AvalonROV/Electrical/Hardware/Power Board/Power-Board.pdf

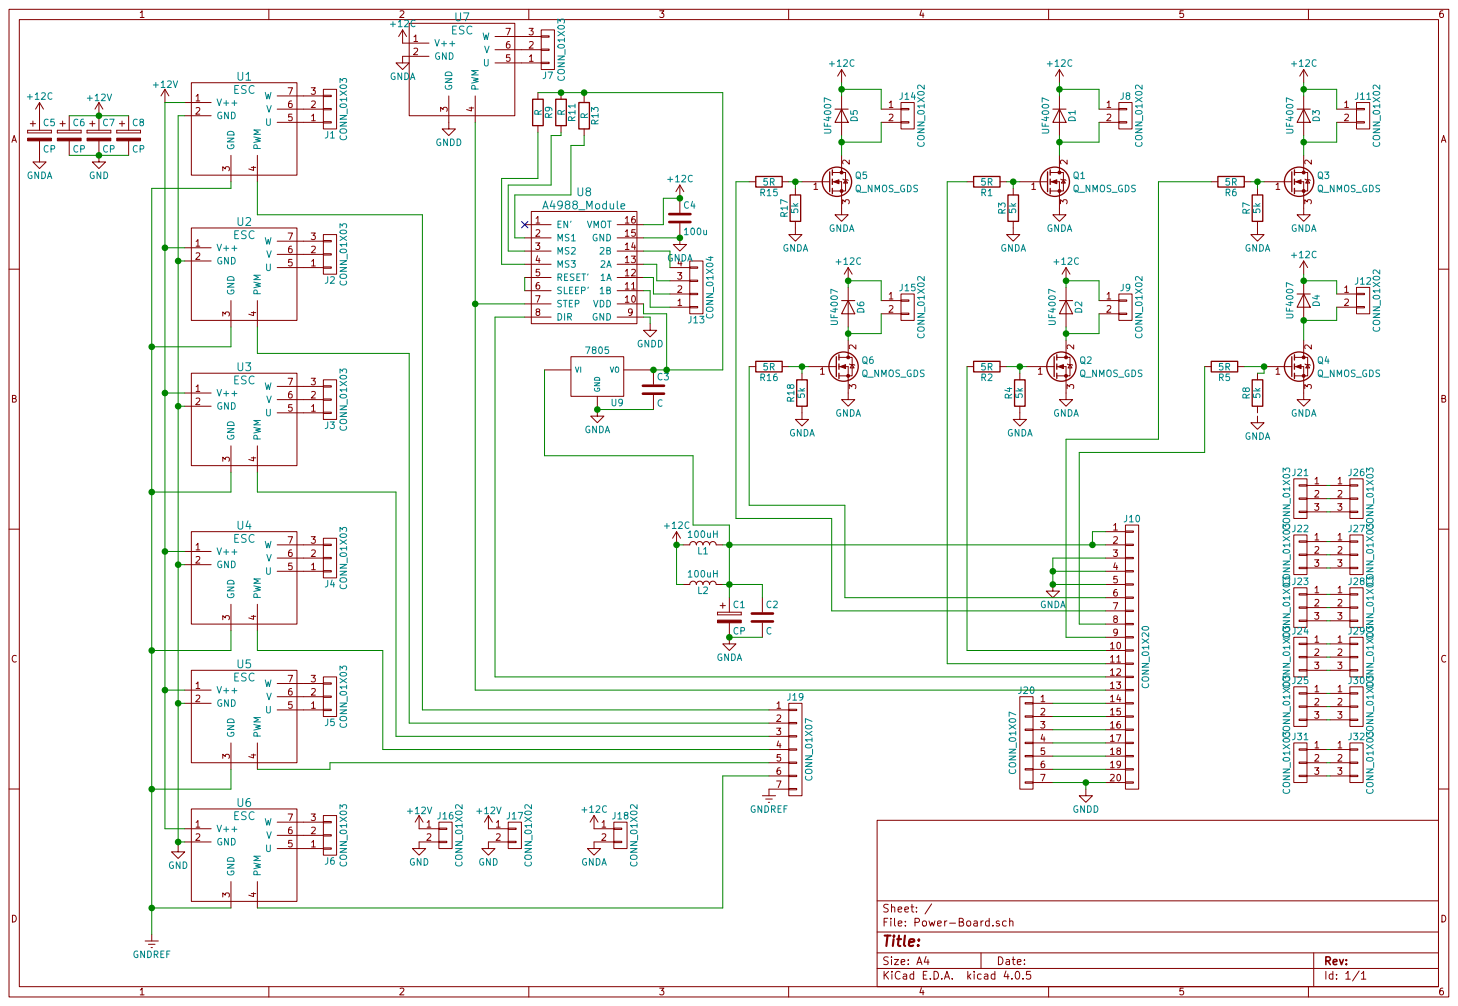
[picture p1: page 1]

15
16
17
18
19
20

J32 CONN_01X03 123

Id: 1/1 Title: File: Power-Board.sch Sheet: /
