AvalonROV/Electrical/Release Mechanism/Ultrasonic Transducer Reciever Circuit.asc

C1: cap; 10n
C2: cap; 10n
C3: cap; 10n
C4: cap; 2500p
D1: diode
R1: res; 1Meg
R2: res; 1Meg
R3: res; 1Meg
R4: res; 12k
R5: res; 1Meg
R6: res; 12k
R7: res; 10k
R9: res; 390k
R10: res; 1Meg
R12: res; 8k
R13: res; 10k
U1: UniversalOpamp2
U2: UniversalOpamp2
U3: UniversalOpamp2
V1: voltage; SINE(0 100m 40k 500u 0 0 10)
V2: voltage; 9
Named nets: 0, TP1, TP4, TP2, TP3
Ultrasonic Transducer
.tran 0 1m 0
