AvalonROV/Electrical/Release Mechanism/Ultrasonic Transducer Transmitter Circuit.asc

C1: cap; 2500p
Q1: npn; BC817-25
Q2: npn; BC817-25
Q3: pnp
Q4: pnp
Q5: npn; BC817-25
R1: res; 1K
R2: res; 1K
R3: res; 1.5K
R4: res; 1.5K
R5: res; 1.5K
R6: res; 1.5K
R7: res; 1.5K
V1: voltage; 12
V2: voltage; PULSE(0 5 0u 0.1u 0.1u 12.5u 25u)
Named nets: 0
.tran 0 10m 0
