AvalonROV/Electrical/(list of files, drawings)

Other design files:
Hardware/Communication Board/avalon_communication_board.dsn
Hardware/Release Mechanism Board/ReleaseBoard.dsn
Hardware/Topside Video Converter/Video Converter.dsn
