AvalonROV/Electrical/Hardware/Release Mechanism Board/ReleaseBoard.kicad_pcb

## KiCad design Hardware/Release Mechanism Board/ReleaseBoard.kicad_pcb (2018-03-21)

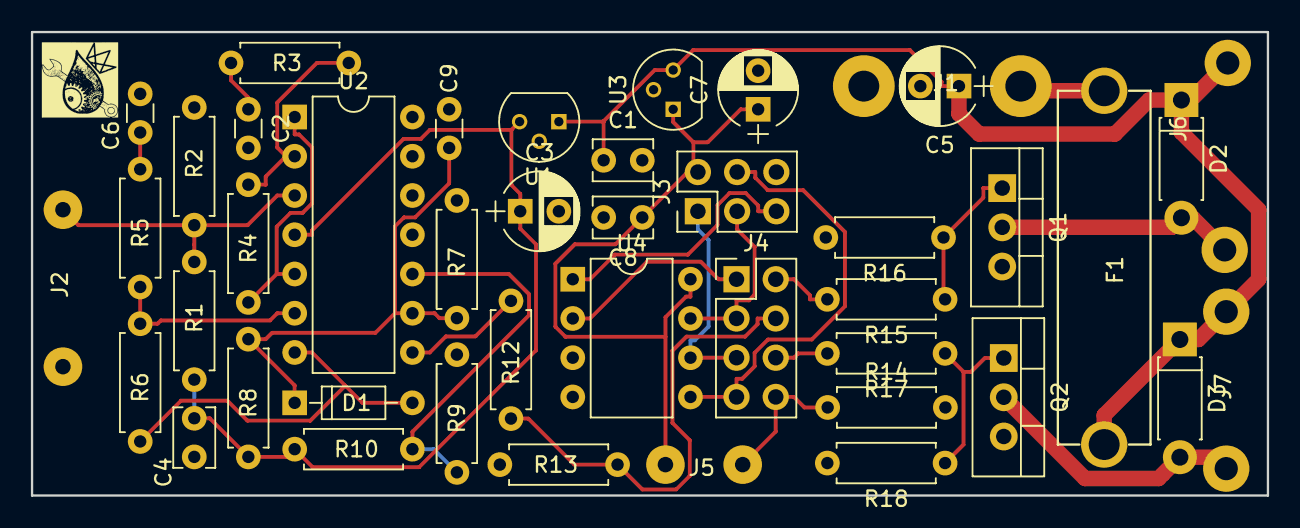
[picture p2: board ReleaseBoard.kicad_pcb from above]

Board: 2 copper layers, 80.0 x 30.0 mm, 43 parts (0 on the bottom side), 28 nets.

Parts:
C1, C4, C8: C; C_Disc_D3.8mm_W2.6mm_P2.50mm
C2, C6, C9: 10n; C_Disc_D3.0mm_W1.6mm_P2.50mm
C3, C5, C7: C; CP_Radial_D5.0mm_P2.50mm
D1: 1N4841; D_DO-35_SOD27_P7.62mm_Horizontal
D2, D3: D; D_DO-41_SOD81_P7.62mm_Horizontal
F1: Fuse; Keystone20x5FuseHolder
J1: CONN_01X02; WireConnection_2.00mmDrill
J2, J5: CONN_01X02; WireConnection_1.00mmDrill
J3: CONN_02X03; Pin_Header_Straight_2x03_Pitch2.54mm
J4: CONN_02X04; Pin_Header_Straight_2x04_Pitch2.54mm
J6, J7: CONN_01X02; WireConnection_1.50mmDrill
Q1, Q2: Q_NMOS_GDS; TO-220-3_Vertical
R1, R2, R4, R6, R9: 1M; R_Axial_DIN0207_L6.3mm_D2.5mm_P7.62mm_Horizontal
R3, R5: 12k; R_Axial_DIN0207_L6.3mm_D2.5mm_P7.62mm_Horizontal
R7, R13: 10k; R_Axial_DIN0207_L6.3mm_D2.5mm_P7.62mm_Horizontal
R8: 4.7M; R_Axial_DIN0207_L6.3mm_D2.5mm_P7.62mm_Horizontal
R10: 390k; R_Axial_DIN0207_L6.3mm_D2.5mm_P7.62mm_Horizontal
R12: 8k; R_Axial_DIN0207_L6.3mm_D2.5mm_P7.62mm_Horizontal
R14, R15, R16, R17, R18: R; R_Axial_DIN0207_L6.3mm_D2.5mm_P7.62mm_Horizontal
U1: LM7809CT; TO-92_Molded_Narrow
U2: LM324; DIP-14_W7.62mm
U3: LM78L05ACZ; TO-92_Molded_Narrow
U4: ATTINY85-20PU; DIP-8_W7.62mm

Connections:
+5V: C7.1, C8.1, J3.2, J5.1, U3.1, U4.8
+12V: C1.1, C5.1, D2.1, D3.1, F1.1, J6.1, J7.1, U1.1, U3.3
GND: C1.2, C2.2, C3.2, C4.2, C5.2, C6.2, C7.2, C8.2, C9.2, J1.2, J2.2, J3.6, Q1.3, Q2.3, R2.2, R7.1, R9.2, R13.2, R14.2, R16.2, R18.2, U1.2, U2.11, U3.2, U4.4
unnamed: C2.1, R3.2
unnamed: C3.1, C4.1, R1.1, R8.1, R10.1, U1.3, U2.4
unnamed: C6.1, R5.2
unnamed: C9.1, D1.1, R7.2, R8.2, U2.9
unnamed: D1.2, R6.1, U2.7
unnamed: D2.2, J6.2, Q1.2
unnamed: D3.2, J7.2, Q2.2
unnamed: F1.2, J1.1
unnamed: J2.1, R1.2, R2.1, U2.3
unnamed: J3.1, J4.5, U4.6
unnamed: J3.3, J4.3, U4.7
unnamed: J3.4, J4.7, U4.5
unnamed: J3.5, U4.1
unnamed: J4.1, U4.2
unnamed: J4.2, R15.2
unnamed: J4.4, R12.2, R13.1
unnamed: J4.6, R17.2
unnamed: J4.8, J5.2, R14.1
unnamed: Q1.1, R15.1, R16.1
unnamed: Q2.1, R17.1, R18.1
unnamed: R3.1, R4.2, U2.2
unnamed: R4.1, U2.1, U2.5
unnamed: R5.1, R6.2, U2.6
unnamed: R9.1, R10.2, U2.10
unnamed: R12.1, U2.8
