AvalonROV/Electrical/Hardware/Topside Video Converter/Video Converter.kicad_pcb

## KiCad design Hardware/Topside Video Converter/Video Converter.kicad_pcb (2018-03-21)

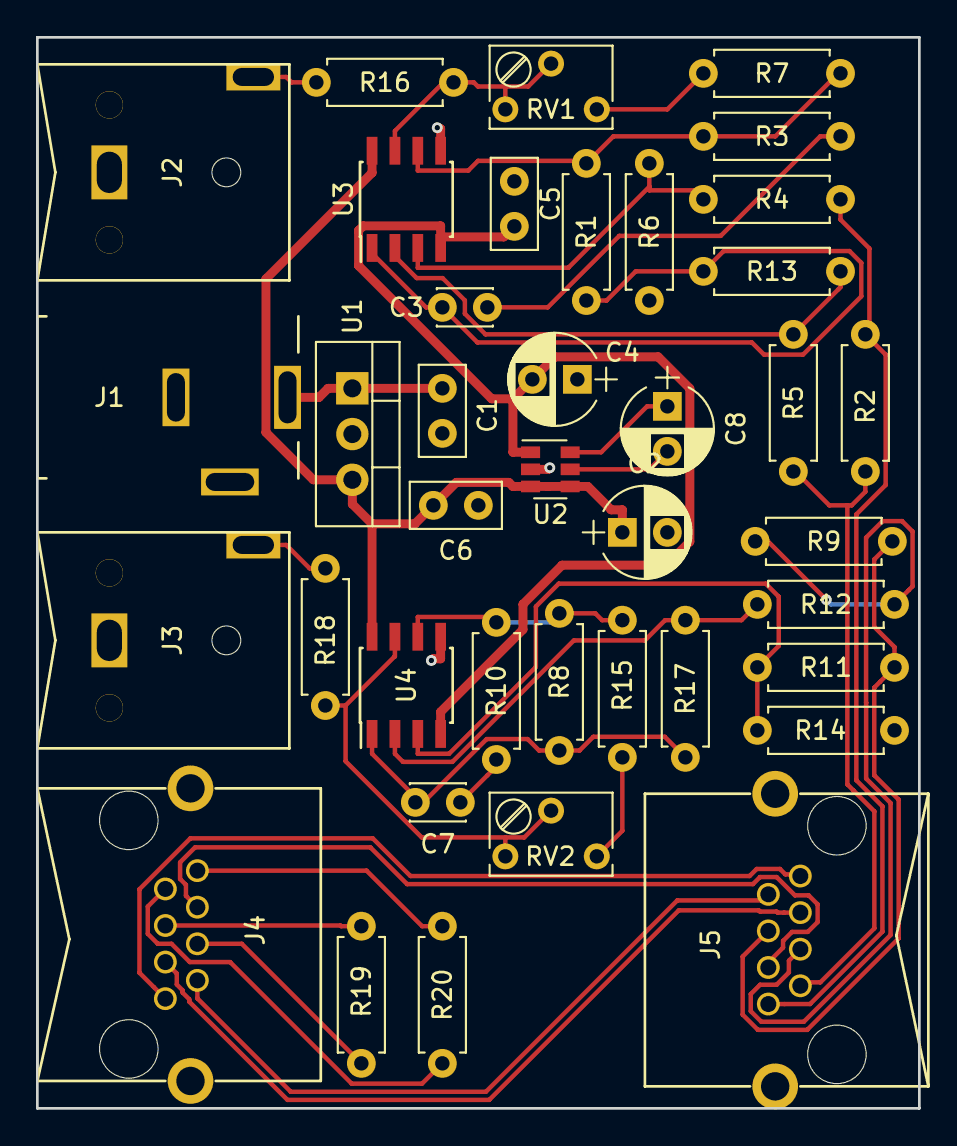
[picture p3: board Video Converter.kicad_pcb from above]

Board: 2 copper layers, 49.0 x 59.5 mm, 39 parts (0 on the bottom side), 34 nets.

Parts:
C1, C5, C6: C; C_Disc_D5.0mm_W2.5mm_P2.50mm
C2: C; CP_Radial_D5.0mm_P2.50mm
C3, C7: 68p; C_Disc_D3.0mm_W2.0mm_P2.50mm
C4: 10u; CP_Radial_D5.0mm_P2.50mm
C8: 1u; CP_Radial_D5.0mm_P2.50mm
J1: CONN_01X02; RS_5.5mmSocket
J2, J3: CONN_01X02; RCA_Jack_4890.2250
J4, J5: RJ45; TE_RJ45
R1, R4, R5, R8, R11, R12, R13, R14, R17: 3k; R_Axial_DIN0207_L6.3mm_D2.5mm_P7.62mm_Horizontal
R2, R9: 86R6; R_Axial_DIN0207_L6.3mm_D2.5mm_P7.62mm_Horizontal
R3, R10: 3k9; R_Axial_DIN0207_L6.3mm_D2.5mm_P7.62mm_Horizontal
R6, R19, R20: R; R_Axial_DIN0207_L6.3mm_D2.5mm_P7.62mm_Horizontal
R7, R15: 1k5; R_Axial_DIN0207_L6.3mm_D2.5mm_P7.62mm_Horizontal
R16, R18: 75R; R_Axial_DIN0207_L6.3mm_D2.5mm_P7.62mm_Horizontal
RV1, RV2: 1k; Potentiometer_Trimmer_Bourns_3266W
U1: LM7805; TO-220-3_Vertical
U2: LM2776; SOT-23-6
U3, U4: OPA2340; SOIC-8_3.9x4.9mm_Pitch1.27mm

Connections:
+5V: C2.1, C6.1, U1.3, U2.3, U2.4, U3.8, U4.8
GND: C1.2, C2.2, C4.1, C5.1, C6.2, J1.1, J2.2, J3.2, J4.9, J5.9, R6.2, R14.2, U1.2, U2.2, U3.5, U4.5
unnamed: C1.1, J1.2, U1.1
unnamed: C3.1, R3.2
unnamed: C3.2, R1.2, R13.1, U3.1
unnamed: C4.2, C5.2, U2.1, U3.4, U4.4
unnamed: C7.1, R10.2
unnamed: C7.2, R8.2, R17.1, U4.1
unnamed: C8.1, U2.6
unnamed: C8.2, U2.5
unnamed: J2.1, R16.1
unnamed: J3.1, R18.1
unnamed: J4.1, J5.1
unnamed: J4.2, J5.2
unnamed: J4.3, J5.3
unnamed: J4.4, R19.1
unnamed: J4.5, R19.2
unnamed: J4.6, J5.6
unnamed: J4.7, R20.1
unnamed: J4.8, R20.2
unnamed: J5.4, R9.1, R11.2
unnamed: J5.5, R9.2, R12.2
unnamed: J5.7, R2.2, R5.2
unnamed: J5.8, R2.1, R4.2
unnamed: R1.1, R3.1, R7.2, U3.6
unnamed: R4.1, R6.1, U3.3
unnamed: R7.1, RV1.3
unnamed: R8.1, R10.1, R15.2, U4.6
unnamed: R11.1, R14.1, U4.3
unnamed: R12.1, R17.2, U4.2
unnamed: R5.1, R13.2, U3.2
unnamed: R15.1, RV2.3
unnamed: R16.2, RV1.1, RV1.2, U3.7
unnamed: R18.2, RV2.1, RV2.2, U4.7
