AvalonROV/Electrical/Hardware/Communication Board/avalon_communication_board.kicad_pcb

## KiCad design Hardware/Communication Board/avalon_communication_board.kicad_pcb (2018-03-19)

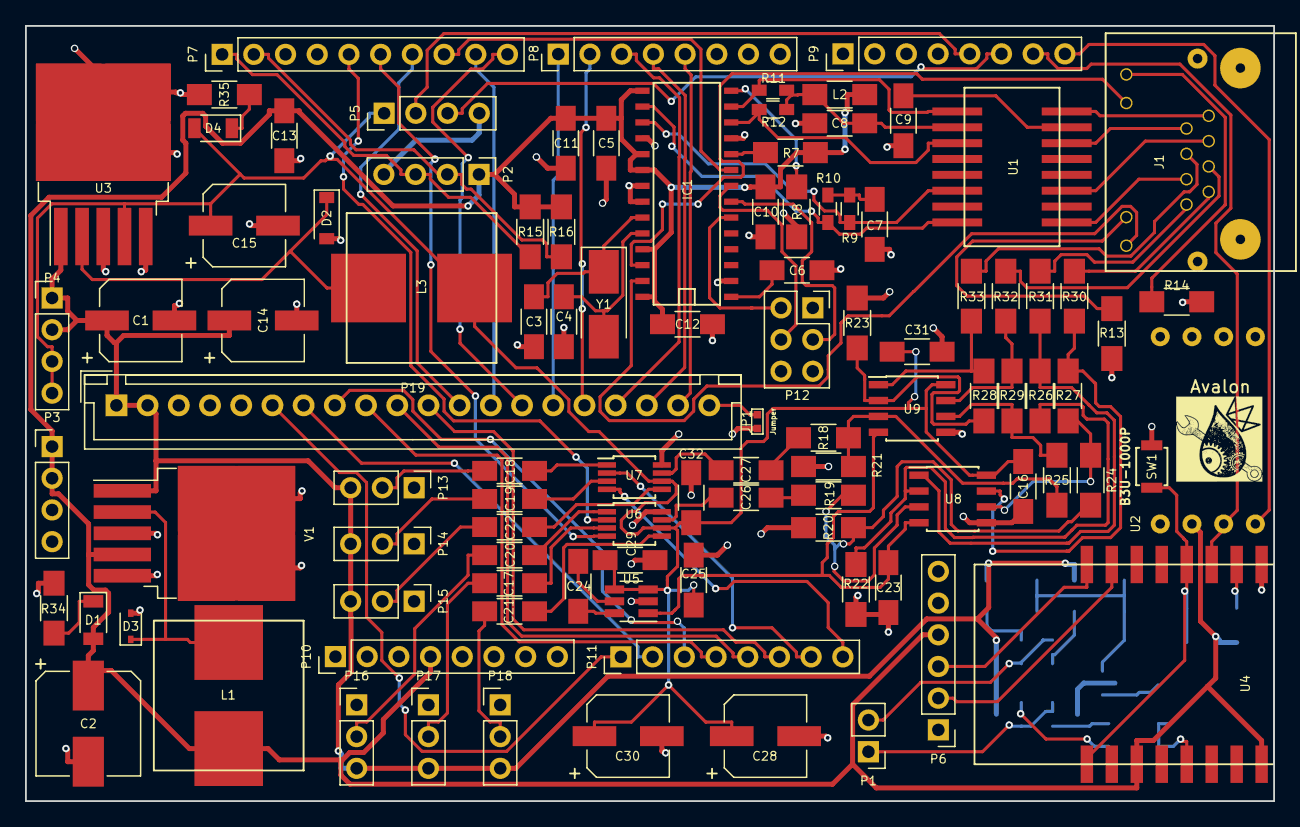
[picture p4: board avalon_communication_board.kicad_pcb from above]

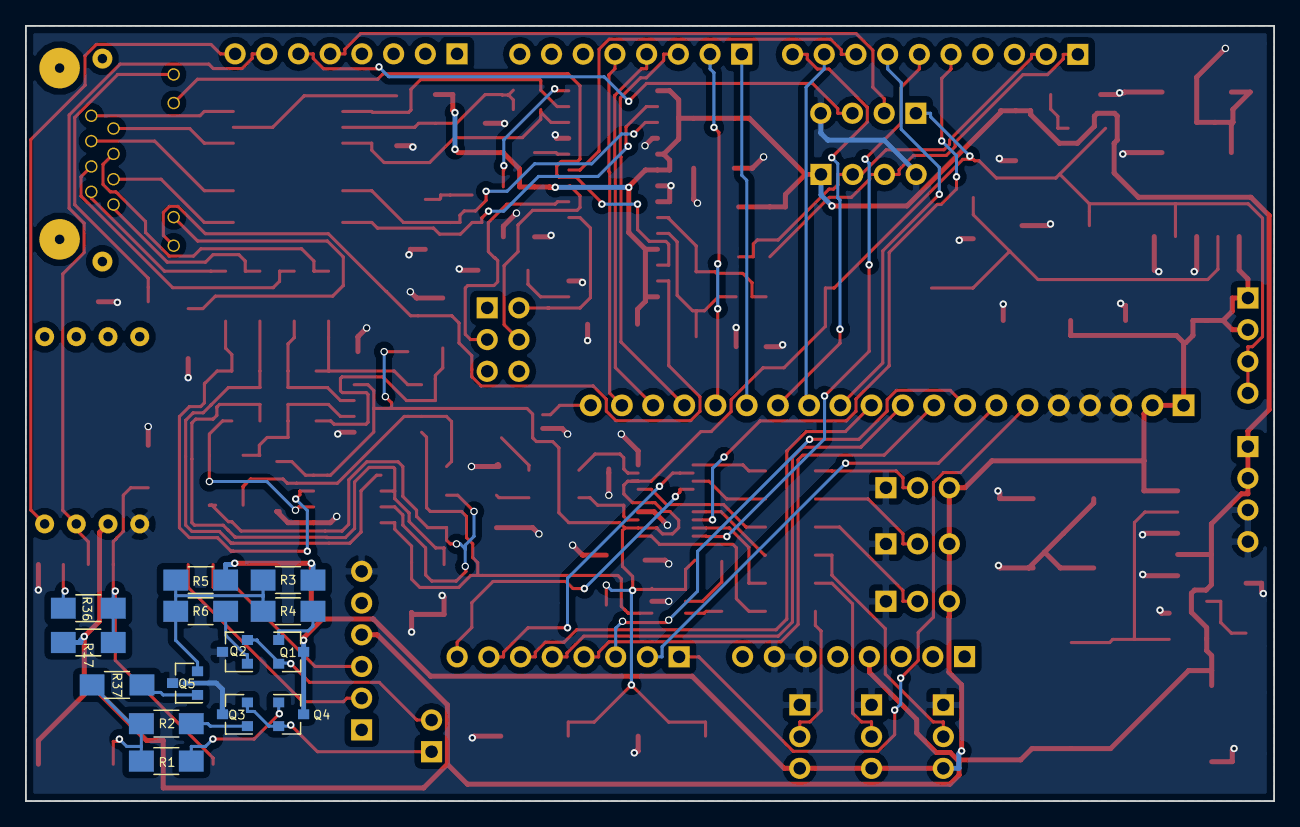
[picture p5: board avalon_communication_board.kicad_pcb from below]

Board: 2 copper layers, 100.0 x 62.1 mm, 115 parts (14 on the bottom side), 103 nets.

Parts:
C1, C14: 100uF; CP_Elec_6.3x7.7
C2: 1000uF; CP_Elec_8x10
C3, C4: 18pF; C_1206_HandSoldering
C5, C10, C11, C12, C17, C18, C19, C20, C21, C22, C25, C29, C31, C32: 0.1uF; C_1206_HandSoldering
C6: 10uF; C_1206_HandSoldering
C7, C8: 10nF; C_1206_HandSoldering
C9: 1nF; C_1206_HandSoldering
C13: 100nF; C_1206_HandSoldering
C15: 330uF; CP_Elec_6.3x7.7
C16, C23: 2.2uF; C_1206_HandSoldering
C24: 1uF; C_1206_HandSoldering
C26, C27: 470uF; C_1206_HandSoldering
C28, C30: 47uF; CP_Elec_6.3x7.7
D1: BAT60BE; D_SOD-323
D2: 1N5819; D_SOD-123
D3, D4: LED; D_1206
IC1: ENC28J60-I/SO; SOIC-28
J1: RJ45_LEDS; RJHSE-5381
JP1: Jumper; 0402
L1: 100uH; MSS1278T-334KLD
L2: Ferrite_Bead; R_1206_HandSoldering
L3: 330uH; MSS1278T-334KLD
P1: MC34629; Socket_Strip_Straight_1x02_Pitch2.54mm
P2, P3, P4, P5: MC34633; Socket_Strip_Straight_1x04_Pitch2.54mm
P6: 6 Pin SIL; Socket_Strip_Straight_1x06_Pitch2.54mm
P7: 10 Pin SIL; Socket_Strip_Straight_1x10_Pitch2.54mm
P8, P9, P10, P11: 8 Pin SIL; Socket_Strip_Straight_1x08_Pitch2.54mm
P12: 2x3 Pin SIL; Socket_Strip_Straight_2x03_Pitch2.54mm
P13, P14, P15, P16, P17, P18: MC34631; Socket_Strip_Straight_1x03_Pitch2.54mm
P19: Power Board Connector; JST_XH_B20B-XH-A_20x2.50mm_Straight
Q1, Q4: FMMT597; SOT-23
Q2, Q3, Q5: BC817; SOT-23
R1, R2, R4, R5, R24, R25, R37: 1.5K; R_1206_HandSoldering
R3, R6: 1K; R_1206_HandSoldering
R7, R17, R36: 100K; R_1206_HandSoldering
R8: 2K; R_1206_HandSoldering
R9, R10, R11, R12: 50R; R_0603_HandSoldering
R13, R14, R34: 100R; R_1206_HandSoldering
R15, R16: 10K; R_1206_HandSoldering
R18, R19, R20, R21: 75R; R_1206_HandSoldering
R22, R23, R26, R27, R28, R29: 3K; R_1206_HandSoldering
R30, R31, R32, R33: 43R; R_1206_HandSoldering
R35: 220R; R_1206_HandSoldering
SW1: B3U-1000P
U1: B78476A8247A003
U2: MPU9250
U3: LM2575S; TO-263-5_TabPin3
U4: ESP-12S; ESP12
U5: LM2776; SOT-23-6_Handsoldering
U6, U7: BH76330FVM; MSOP-8_3x3mm_Pitch0.65mm
U8, U9: LMH6643; SOIC-8_3.9x4.9mm_Pitch1.27mm
V1: LM2576; TO-263-5_TabPin3
Y1: ABM3-25MHz; Crystal_SMD_5032-2pin_5.0x3.2mm_HandSoldering

Connections:
+3V3: C2.1, C5.1, C10.1, C11.1, C12.1, C13.1, D3.2, IC1.15, IC1.19, IC1.20, IC1.25, IC1.28, L1.2, L2.1, P2.1, P3.1, P3.2, P6.4, P10.4, R7.1, R15.1, R16.1, R17.1, U2.3, U4.3, U4.8, V1.4
+5V: C15.1, C16.1, C25.1, C28.1, C29.1, C30.1, C31.1, C32.1, D4.2, L3.1, P4.3, P4.4, P5.1, U3.4, U5.3, U5.4, U6.6, U7.6, U8.8, U9.8
+12V: C1.1, C14.1, P4.1, P4.2, P13.3, P14.3, P15.3, P16.3, P17.3, P18.3, P19.1, P19.2, Q1.3, Q4.3, R3.1, R6.1, U3.1, V1.1
-5V: C23.1, U5.1, U8.4, U9.4
BLUE_RX: P5.2, P9.5
BLUE_TX: P5.3, P9.6
CAM1A: J1.8, R31.1
CAM1B: J1.7, R30.1
CAM2A: J1.4, R33.1
CAM2B: J1.5, R32.1
ESP_SCL: P9.8, U2.1
ESP_SDA: P9.7, U2.2, U4.11
Ether_CS': IC1.9, P7.8
Ether_SCK: IC1.8, P12.4
Ether_SI: IC1.7, P12.3
Ether_SO: IC1.6, P12.2
GND: C1.2, C2.2, C3.2, C4.2, C5.2, C6.2, C7.2, C8.2, C9.2, C10.2, C11.2, C12.2, C13.2, C14.2, C15.2, C16.2, C23.2, C25.2, C28.2, C29.2, C30.2, C31.2, C32.2, D1.2, D2.2, IC1.2, IC1.11, IC1.18, IC1.21, IC1.22, JP1.2, P2.4, P3.3, P3.4, P5.4, P6.6, P10.6, P10.7, P13.1, P14.1, P15.1, P16.1, P17.1, P18.1, P19.3, P19.4, P19.5, Q2.3, Q3.3, Q5.3, R8.2, R13.2, R14.1, R20.2, R21.2, R22.2, R23.2, R34.2, R35.2, SW1.1, U2.4, U3.3, U3.5, U4.9, U5.2, U6.8, U7.8, U8.5, U9.5, V1.3, V1.5
GPIO_11: P7.7, P19.12
GPIO_12: P7.6, U6.4
GPIO_13: P7.5, U6.2
GPIO_54: P11.1, P19.6
GPIO_55: P11.2, P19.7
GPIO_56: P11.3, P19.8
GPIO_57: P11.4, P19.9
GPIO_58: P11.5, P19.10
GPIO_59: P11.6, P19.11
GPIO_60: P11.7, U7.2
GPIO_61: P11.8, U7.4
LEDA: IC1.27, J1.12
LEDB: IC1.26, J1.10
unnamed: C3.1, IC1.23, Y1.1
unnamed: C4.1, IC1.24, Y1.2
unnamed: C6.1, IC1.1
unnamed: C7.1, R9.2, R10.1
unnamed: C8.1, L2.2, R11.2, R12.1, U1.2
unnamed: C9.1, U1.15
unnamed: C17.1, U6.3
unnamed: C17.2, P17.2
unnamed: C18.1, U7.1
unnamed: C18.2, P13.2
unnamed: C19.1, P15.2
unnamed: C19.2, U7.5
unnamed: C20.1, P16.2
unnamed: C20.2, U6.1
unnamed: C21.1, U6.5
unnamed: C21.2, P18.2
unnamed: C22.1, U7.3
unnamed: C22.2, P14.2
unnamed: C24.1, U5.6
unnamed: C24.2, U5.5
unnamed: C26.1, U6.7
unnamed: C26.2, R19.1
unnamed: C27.1, U7.7
unnamed: C27.2, R18.1
unnamed: D1.1, L1.1, V1.2
unnamed: D2.1, L3.2, U3.2
unnamed: D3.1, R34.1
unnamed: D4.1, R35.1
unnamed: IC1.10, R7.2
unnamed: IC1.12, R12.2, U1.3
unnamed: IC1.13, R11.1, U1.1
unnamed: IC1.14, R8.1
unnamed: IC1.16, R10.2, U1.8
unnamed: IC1.17, R9.1, U1.6
unnamed: J1.1, U1.16
unnamed: J1.2, U1.14
unnamed: J1.3, U1.11
unnamed: J1.6, U1.9
unnamed: J1.9, R14.2
unnamed: J1.11, R13.1
unnamed: JP1.1, P19.20
unnamed: P1.1, Q3.2, Q4.2
unnamed: P1.2, Q1.2, Q2.2
unnamed: P6.2, U4.15
unnamed: P6.3, U4.16
unnamed: Q1.1, R4.1
unnamed: Q2.1, R5.2
unnamed: Q3.1, R2.2
unnamed: Q4.1, R1.1
unnamed: Q5.1, R37.2
unnamed: Q5.2, R3.2, R4.2, R5.1, R6.2
unnamed: R17.2, R36.2, SW1.2, U4.1, U4.12
unnamed: R18.2, R21.1, R25.2, U9.3
unnamed: R19.2, R20.1, R24.2, U8.3
unnamed: R22.1, R26.2, U8.2
unnamed: R23.1, R28.2, U9.2
unnamed: R24.1, R27.2, U8.6
unnamed: R25.1, R29.2, U9.6
unnamed: R26.1, R31.2, U8.1
unnamed: R27.1, R30.2, U8.7
unnamed: R28.1, R33.2, U9.1
unnamed: R29.1, R32.2, U9.7
unnamed: R36.1, U4.10
POW_PWM_0: P7.9, P19.13
POW_PWM_1: P7.10, P19.14
POW_PWM_2: P8.1, P19.15
POW_PWM_3: P8.2, P19.16
POW_PWM_4: P8.3, P19.17
POW_PWM_5: P8.4, P19.18
POW_PWM_6: P8.5, P19.19
P_SCL: P2.3, P7.1, R15.2
P_SDA: P2.2, P7.2, R16.2
ULTRA_CTRL: R1.2, R2.1, R37.1, U4.5
