AvalonROV/Electrical/Hardware/Topside Video Converter/Fathom-S.brd

## EAGLE design Hardware/Topside Video Converter/Fathom-S.brd (2018-03-21)

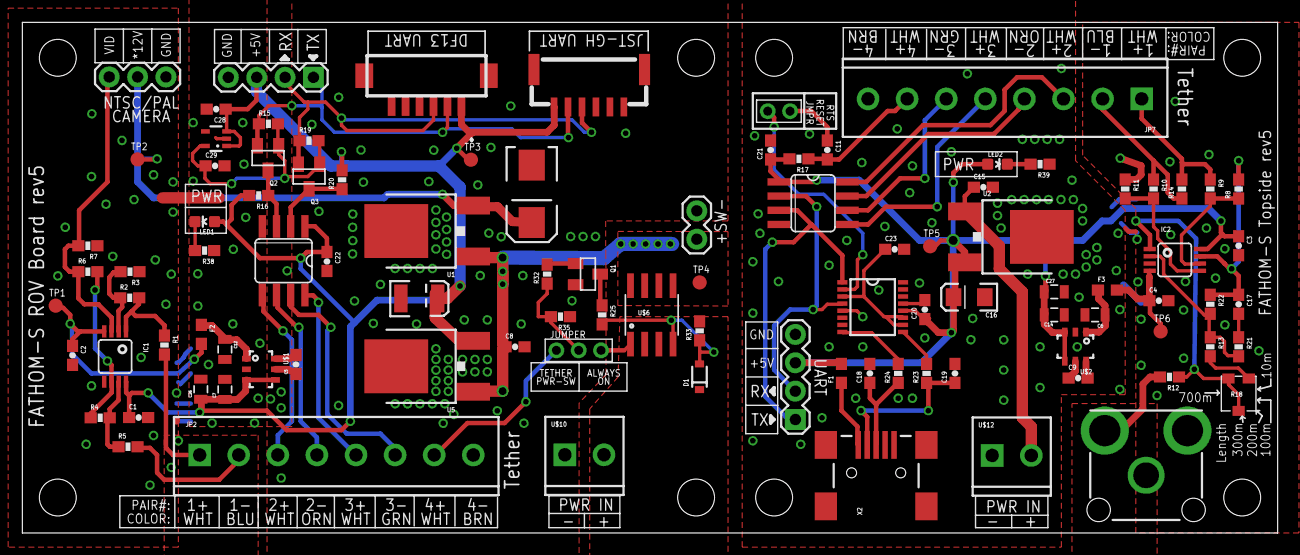
[picture p6: board Fathom-S.brd from above]

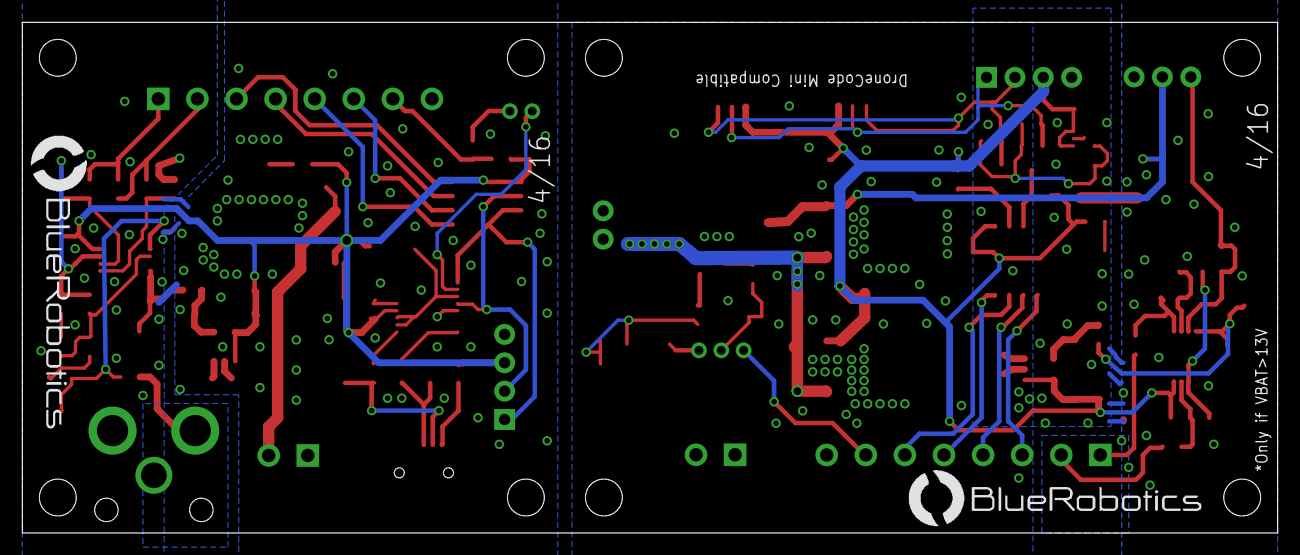
[picture p7: board Fathom-S.brd from below]

Board: 2 copper layers, 112.4 x 45.7 mm, 110 parts (2 on the bottom side), 64 nets.

Parts:
C1, C2, C3, C4, C8, C15, C20, C21, C22, C23: 0.1uF; 0603-CAP
C5, C9: 1uF X5R 35V; 0603-CAP
C6, C7, C12, C14, C26, C27: 10uF X5R 10V; 0805
C10: 47uF 10V; EIA3528
C11, C28, C29: 1uF; 0603-CAP
C13: 33uF 20V; C2413
C16: 10uF 16V; EIA3216
C17: 68pF; 0603-CAP
C18, C19: 47pF; 0603-CAP
D1: 16V; SOD-323
F1, F2, F3: 500mA; 0603
IC1, IC2: LMH6643; MSOP8
IC3, IC4: ST490AB; SO08
IC5: FT230XS; SSOP16
JP1: 1X04
JP2, JP7: 3.5MM SCREW; SCREWTERMINAL-3.5MM-8
JP3: 0.1" HEADER; 1X03
JP5: M02PTH; 1X02
JP6: PJRAN1X1U04X; RCA
JP15: 0.1" HEADER; 1X04
LED1, LED2: GREEN; LED-0603
Q1: BC817-40W; SOT23
Q2, Q3: BSS138; SOT23
R1, R5: 43; 0603-RES
R2, R3, R4, R8, R9, R10, R11, R22: 3K; 0603-RES
R6, R13: 1.5K; 0603-RES
R7, R12: 75; 0603-RES
R14: 86.6; 0603-RES
R15, R16, R19, R20, R25: 10K; 0603-RES
R17, R32, R35: 47K; 0603-RES
R18: TC33X-2-102E; TRIMPOT_TC33
R21: 3.9K; 0603-RES
R23, R24: 27; 0603-RES
R33: 5.1K; 0603-RES
R38, R39: 330; 0603-RES
STANDOFF1, STANDOFF2, STANDOFF3, STANDOFF4, STANDOFF5, STANDOFF6, STANDOFF7, STANDOFF8: STAND-OFF
TP1, TP6: -5V; B1,27
TP2: 12V; B1,27
TP3, TP5: 5V; B1,27
TP4: VIN; B1,27
U1: MC7812; DPAK
U2, U5: MC7805; DPAK
U$1, U$2: LM2776; SOT-23-6
U$3: DF13-6P-1.25V; DF13C-6P-1.25V
U$4, U$7: LOGOFULL-M; BR-FULL-LOGO-MEDIUM
U$5: LOGOBR-LOGO-MS-COPPER; BR-LOGO-MEDIUM-SMALL-COPPER
U$6: AO4407A; SO08
U$9: LOGOBR-LOGO-MS; BR-LOGO-MEDIUM-SMALL-COPPER
U$10, U$12: M023.5MM; SCREWTERMINAL-3.5MM-2
U$11: JST-GH-6TOP-ENTRY; JST-GH-TOP-6
U$13: HEADER-33MM; HEADER-2MM-3POS
U$15: VREG-MIC5365; SC70-5L
U$16: HEADER-22MM; HEADER-2MM-2POS
X2: USBSMD; USB-MINIB

Connections:
3.3V-ISO: C29.1, Q2.1, Q3.1, R15.2, R19.2, U$15.5
3V3OUT: C23.1, IC5.3, IC5.10, IC5.11
12V-ISO: C13.+, JP3.2, TP2.TP, U1.3
-VCC: C4.1, F3.2, IC2.4, TP6.TP
-VCC-ISO: C2.1, F2.2, IC1.4, TP1.TP
-VCC-ISO-PRE: C12.1, F2.1, U$1.1
-VCC-PRE: C6.1, F3.1, U$2.1
CAMERA: IC1.3, JP3.3, R6.1, R7.2
GND: C3.2, C4.2, C6.2, C14.2, C15.2, C16.C, C18.2, C19.2, C20.2, C21.2, C23.2, C27.2, IC2.3, IC3.4, IC5.5, IC5.13, JP6.SHELL, JP7.8, JP15.4, R11.1, R39.1, U2.4, U$2.2, U$12.1, X2.GND
GND-ISO: C1.2, C2.2, C7.2, C8.2, C10.C, C12.2, C13.-, C22.2, C26.2, C28.2, C29.2, IC1.5, IC4.4, JP1.4, JP2.8, JP3.1, JP5.1, Q1.2, R3.1, R7.1, R35.1, R38.1, U1.4, U5.4, U$1.2, U$3.P$6, U$10.1, U$11.6, U$15.2
unnamed: IC1.1, R1.1, R2.2
unnamed: IC1.7, R4.2, R5.1
unnamed: C9.1, U$2.5
unnamed: C9.2, U$2.6
unnamed: IC1.2, R2.1, R3.2
unnamed: IC1.6, R4.1, R6.2
unnamed: C11.1, U$16.P$1
unnamed: IC2.5, R10.2, R11.2
unnamed: IC2.6, R8.1, R9.2
unnamed: C5.1, U$1.5
unnamed: C5.2, U$1.6
unnamed: R13.2, R18.1
unnamed: C17.1, IC2.7, R8.2, R22.1
unnamed: IC2.2, R13.1, R21.2, R22.2
unnamed: C17.2, R21.1
unnamed: IC2.1, R12.1, R18.2, R18.3
unnamed: C19.1, R23.1, X2.D-
unnamed: C18.1, R24.1, X2.D+
unnamed: F1.1, X2.VBUS
unnamed: IC5.8, R24.2
unnamed: Q1.1, R32.2
unnamed: D1.A, R25.2, R33.1, U$6.4
unnamed: IC5.9, R23.2
unnamed: Q1.3, R25.1
unnamed: LED1.C, R38.2
unnamed: LED2.C, R39.2
ROV-BATT: D1.C, R33.2, U$6.1, U$6.2, U$6.3, U$10.2, U$13.P$3
ROV-ON: JP2.7, U$13.P$1
ROV-ON-CTRL: C11.2, JP7.7, R17.1
ROV-ON-SELECT: R32.1, R35.2, U$13.P$2
ROV-RX: IC4.2, Q3.3, R20.1
ROV-TP1+: JP2.1, R1.2
ROV-TP1-: JP2.2, R5.2
ROV-TP2+: IC4.5, JP2.3
ROV-TP2-: IC4.6, JP2.4
ROV-TP3+: IC4.8, JP2.5
ROV-TP3-: IC4.7, JP2.6
ROV-TX: IC4.3, Q2.3, R16.1
ROV-VIN: C8.1, JP5.2, TP4.TP, U1.1, U5.1, U$6.5, U$6.6, U$6.7, U$6.8
RTS: IC5.2, U$16.P$2
RX-3.3V: JP1.2, Q3.2, R19.1, U$3.P$3, U$11.3
RX-I: IC3.2, IC5.4, JP15.2
TOP-TP1+: JP7.1, R9.1, R14.2
TOP-TP1-: JP7.2, R10.1, R14.1
TOP-TP2+: IC3.8, JP7.3
TOP-TP2-: IC3.7, JP7.4
TOP-TP3+: IC3.5, JP7.5
TOP-TP3-: IC3.6, JP7.6
TOP-VIN: C15.1, U2.1, U$12.2
TX-3.3V: JP1.1, Q2.2, R15.1, U$3.P$2, U$11.2
TX-O: IC3.3, IC5.1, JP15.1
VCC: C3.1, C14.1, C16.A, C20.1, C21.1, C27.1, F1.2, IC2.8, IC3.1, IC5.12, JP15.3, LED2.A, R17.2, TP5.TP, U2.3, U$2.3, U$2.4
VCC-ISO: C1.1, C7.1, C10.A, C22.1, C26.1, C28.1, IC1.8, IC4.1, JP1.3, LED1.A, R16.2, R20.2, TP3.TP, U5.3, U$1.3, U$1.4, U$3.P$1, U$11.1, U$15.1, U$15.3
VIDEO-OUT: JP6.PIN, R12.2
