AvalonROV/Electrical/(commit log)

2018-02-15 -KiCad Project Created
    -Created KiCad Project and Schematic
    -Started design of 12V to 3.3V DC Regulator
    [avalon_communication_board.kicad_pcb, avalon_communication_board.sch]
2018-02-16 -Changed voltage regulator part to 12 - 3.3VDC Buck Converter -Updated voltage regulator schematic for new Buck Converter with new components as per datasheet
    [avalon_communication_board.sch]
2018-02-19 Started addition of Ultrasonic Transducer Control Circuitry
    -Started schematic for H Bridge Circuit to drive Ultrasonic Transducer
    [avalon_communication_board.sch]
2018-02-22 -Ultrasonic Transducer Driver Circuit completed
    [avalon_communication_board.sch]
2018-02-22 -Started production of Ethernet Controller Design -Updated Ultrasonic Transducer Driver Circuit to use 12V Supply instead of 5V Supply
    [avalon_communication_board.sch]
2018-02-22 -Continued work on Ethernet Controller
    [avalon_communication_board.sch]
2018-02-23 -Continued work on the ethernet controller
    [avalon_communication_board.sch]
2018-02-24 -Ethernet Controller Main Schematic Updated
    -Main schematic almost complete with Pulse Transformers and Filtering
    -Capacitors for Crystal Oscillator need adding
    -Ethernet Controller schematic block added to main schematic sheet
    [avalon_communication_board.sch, ethernet_controller.sch]
2018-02-25 -Continued work on the Ethernet Controller Schematic
    [avalon_communication_board.sch, ethernet_controller.sch]
2018-02-26 -Ethernet controller schematic complete -Ferrite Bead component changed -Components selected and added to the communications board BOM, located in Google Drive -Filter Capacitor values changed to rec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
    [avalon_communication_board.sch, ethernet_controller.sch]
2018-02-28 -Started adding schematic symbol for ESP8266
2018-03-01 -Added Main Due Connector, 12 - 5V Regulator, I2C Bus Connections
    [avalon_communication_board.sch, ethernet_controller.sch]
2018-03-02 -Added the ESP8266 Microcontroller and support circuitry for programming
    [avalon_communication_board.sch, ethernet_controller.sch]
2018-03-02 -Arduino Due Connector completed
    [avalon_communication_board.sch]
2018-03-02 -Updates made to Arduino Due Connector -Updates made to Ultrasonic Transducer Control Circuit -Moved schematic sections around to make space -Added camera electronics sub sheet
    [avalon_communication_board.sch, camera_electronics.sch, ethernet_controller.sch]
2018-03-03 -Added camera transmission and switching electronics
    -Added the camera switching chips from ROHM Semiconductor to enable
    switching between 6 different video channels
    -Added the camera transmission electronics taken from Blue Robotics
    -Added 5V to -5V converter to drive camera transmission electronics
    [avalon_communication_board.sch, ethernet_controller.sch]
2018-03-04 -Added a folder system to the hardware development folder for the different circuit board contained within the ROV -Added a PDF printout of the power board schematic
    [avalon_communication_board.kicad_pcb, avalon_communication_board.sch, camera_electronics.sch, ethernet_controller.sch]
2018-03-04 -Completed wiring of Power Board Connector -Connected Camera Video Signals to RJ45 Connector
    [avalon_communication_board.sch, camera_electronics.sch, ethernet_controller.sch]
2018-03-05 -Fixed issue with -5V line in Camera Transmission electronics pointing upwards on schematic -Centred schematic layouts -Fixed issue where project file seemed to have been removed from the directory -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
    [avalon_communication_board.sch, camera_electronics.sch, ethernet_controller.sch]
2018-03-05 -Ran electrical rules check and made changes to the schematic to fix errors in connections, etc. -Updated PDF with new schematic.
    [avalon_communication_board.sch, camera_electronics.sch, ethernet_controller.sch]
2018-03-05 -Updated schematic sheet name and company name
    [avalon_communication_board.sch, camera_electronics.sch, ethernet_controller.sch]
2018-03-05 -Updated schematic PDF to reflect previous schematic updates
2018-03-06 -Started assigning footprints to components within schematic -Added jumper between separate grounds on power connector -Created footrprints for obscure parts
    [avalon_communication_board.sch, camera_electronics.sch, ethernet_controller.sch]
2018-03-08 -All footprints assigned to components apart from the MPU9250 IMU
    [avalon_communication_board.sch, camera_electronics.sch, ethernet_controller.sch]
2018-03-08 -Added Kicad PCB for communication board -Started component layout on PCB -Swapped some components for smaller SMD equivalents to improve PCB density -Started testing autorouting of board
    [avalon_communication_board.dsn, avalon_communication_board.sch]
2018-03-09 -Locked arduino header footprints to ensure they are not moved from their precise locations -Removed all footprints from board area to begin more optimal routing session
    [avalon_communication_board.dsn, avalon_communication_board.kicad_pcb]
2018-03-11 -Layout and Routing complete for communication board -Silk Screen of board needs changing in order to produce a readable output -Design Rules file created -Footprint for MPU9250 created
    [avalon_communication_board.dsn, avalon_communication_board.kicad_pcb, avalon_communication_board.sch, camera_electronics.sch]
2018-03-12 -Completed circuit board autorouting -Generated test Gerber files to check pricing of circuit board -Significantly reduced layout size through component placement optimization
    [avalon_communication_board-B.Cu.gbl, avalon_communication_board-B.Mask.gbs, avalon_communication_board-B.SilkS.gbo, avalon_communication_board-Edge.Cuts.gm1, avalon_communication_board-F.Cu.gtl, avalon_communication_board-F.Mask.gts, avalon_communication_board-F.SilkS.gto, avalon_communication_board-NPTH.drl]
2018-03-15 -Updated PCB layout to ensure decoupling capacitors are close to IC's -Re routed Arduino Due SPI connector to ensure pinout is correct
    [avalon_communication_board.kicad_pcb, avalon_communication_board.sch, camera_electronics.sch]
2018-03-17 -Moved capacitors for camera switching and transmission section to ensure decoupling operates correctly -Communication Board PCB Routing and Design Complete -Silk Screen of Communication Board modifi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
    [avalon_communication_board-B.Cu.gbl, avalon_communication_board-B.Mask.gbs, avalon_communication_board-B.SilkS.gbo, avalon_communication_board-Edge.Cuts.gm1, avalon_communication_board-F.Cu.gtl, avalon_communication_board-F.Mask.gts, avalon_communication_board-F.SilkS.gto, avalon_communication_board-NPTH.drl]
2018-03-17 -Updated schematic PDF to latest version
2018-03-17 -Added simulation file for ultrasonic transducer transmitter circuit
2018-03-17 -Fixed issue in ultrasonic transducer transmitter circuitry where transistor did not have base current limiting resistor -Updated PCB to account of additional resistor for ultrasonic transducer circu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
    [avalon_communication_board-B.Cu.gbl, avalon_communication_board-B.Mask.gbs, avalon_communication_board-B.SilkS.gbo, avalon_communication_board-Edge.Cuts.gm1, avalon_communication_board-F.Cu.gtl, avalon_communication_board-F.Mask.gts, avalon_communication_board-F.SilkS.gto, avalon_communication_board-NPTH.drl]
2018-03-17 -Updated schematic pdf to reflect changes
2018-03-19 -Added the Avalon Logo to the Communication Board PCB -Added the Avalon Logo Footprint File -Added the Avalon Logo to the Communication Board Schematic -Added the release mechanism circuit board file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
    [ReleaseBoard.dsn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]
2018-03-20 -Completed Ultrasonic Receiver Circuit simulation -Modified Ultrasonic Receiver Circuit based upon simulation results
    [ReleaseBoard.sch]
2018-03-21 -Release mechanism board updated with new peak detector design -Changes to release mechansim board PCB made -Added small version of Avalon logo -Regenerated release mechansim board gerber and drill f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
    [ReleaseBoard-B.Cu.gbl, ReleaseBoard-B.Mask.gbs, ReleaseBoard-B.SilkS.gbo, ReleaseBoard-Edge.Cuts.gm1, ReleaseBoard-F.Cu.gtl, ReleaseBoard-F.Mask.gts, ReleaseBoard-F.SilkS.gto, ReleaseBoard.drl]
2018-03-21 -Updated release mecahnsim board with fuse
    [Fathom-S.brd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]
2018-03-21 -Added release mechansim board ZIP file
2018-03-21 -Updated release mechanism board with condensed design -Updated release mechanism board gerber files
    [ReleaseBoard-B.Cu.gbl, ReleaseBoard-B.Mask.gbs, ReleaseBoard-B.SilkS.gbo, ReleaseBoard-Edge.Cuts.gm1, ReleaseBoard-F.Cu.gtl, ReleaseBoard-F.Mask.gts, ReleaseBoard-F.SilkS.gto, ReleaseBoard.drl]
2018-03-29 -Added Arduino Code for testing WIFI Signal Strength and Ping under water
2018-04-22 Arduino code for video qualification
2018-04-24 Stepper control added
2018-04-24 -Test code for ENC28J60 Ethernet Controller, allows the reading of a control register to test hardware core functionality. Uses SPI communication and prewritten for Arduino Due.
2018-06-02 -Converted the test code to use the UIPEthernet Library for compatability with Arduino Due
2018-06-12 -Added additional test code for the Ethernet Controller -Added test code for the video switching functionality of the communication board
